PA3EFR/radio_timer_project/ESP32-WeMos-LOLIN32-Lite-pinout-mischianti-low-1024x545.jpg

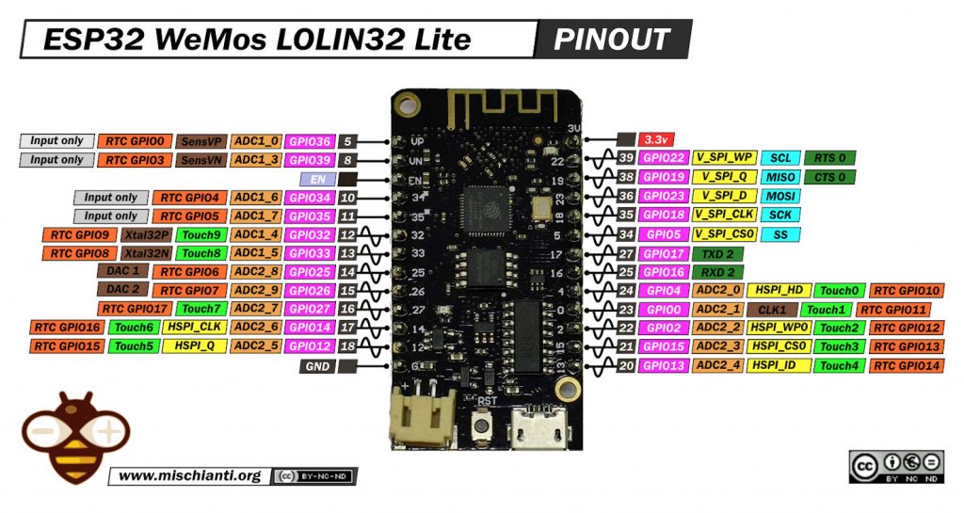
ESP32-WeMos-LOLIN32-Lite-pinout-mischianti-low-1024x545.jpg
