PA3EFR/radio_timer_project/IMG-20251202-WA0028.jpg

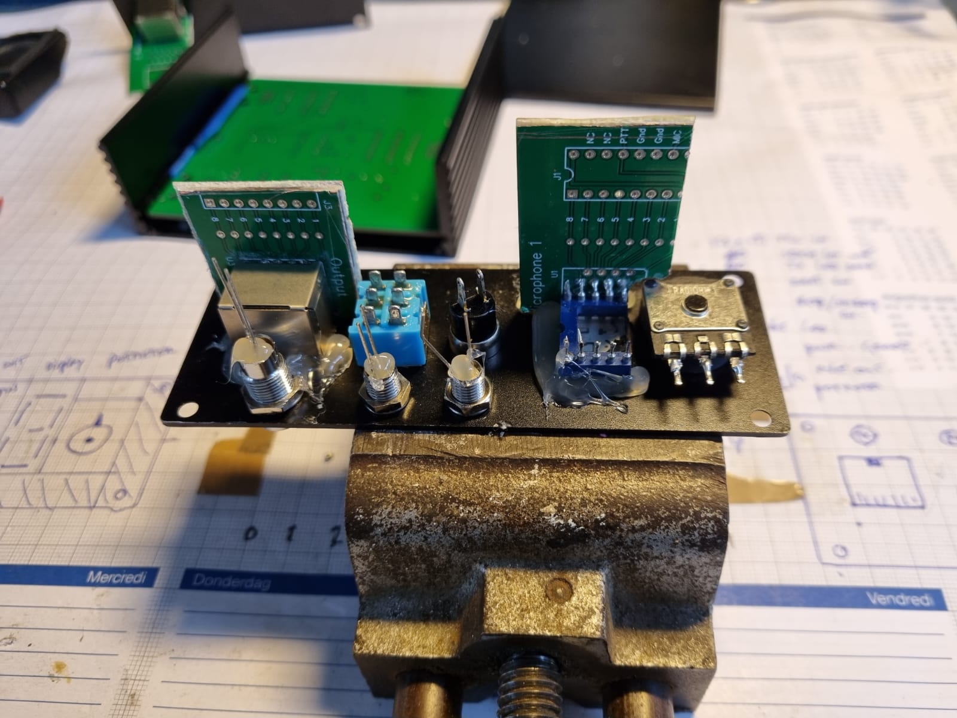
IMG-20251202-WA0028.jpg
