PA3EFR/radio_timer_project/7_Segement_display.jpg

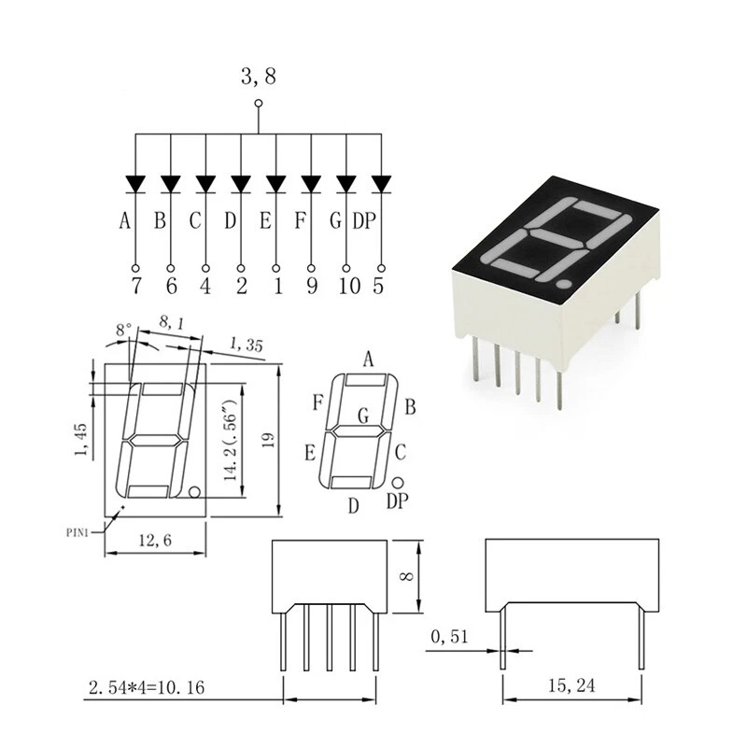
7_Segement_display.jpg
