PA3EFR/radio_timer_project/Mic_layout_GM950.jpg

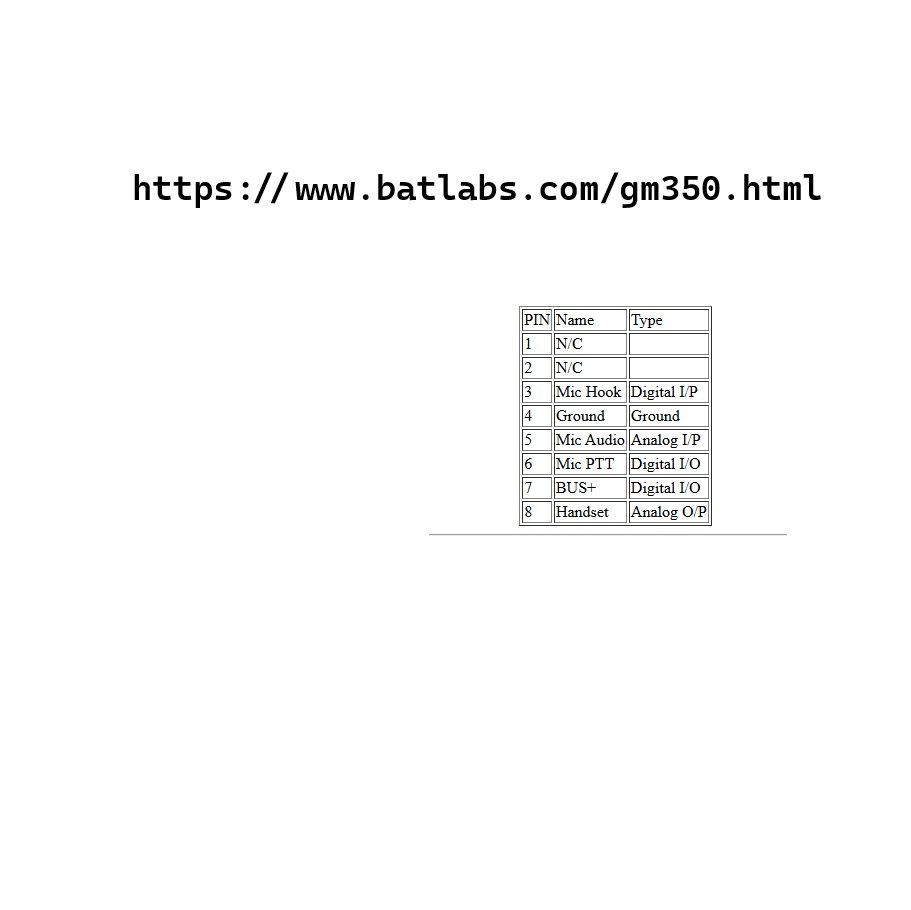
Mic_layout_GM950.jpg
