PA3EFR/radio_timer_project/Lolin32 Lite/Schematic_Audio_timer_Lolin32_2025-12-01.pdf

## ARDUINO LOLIN32 Lite

8

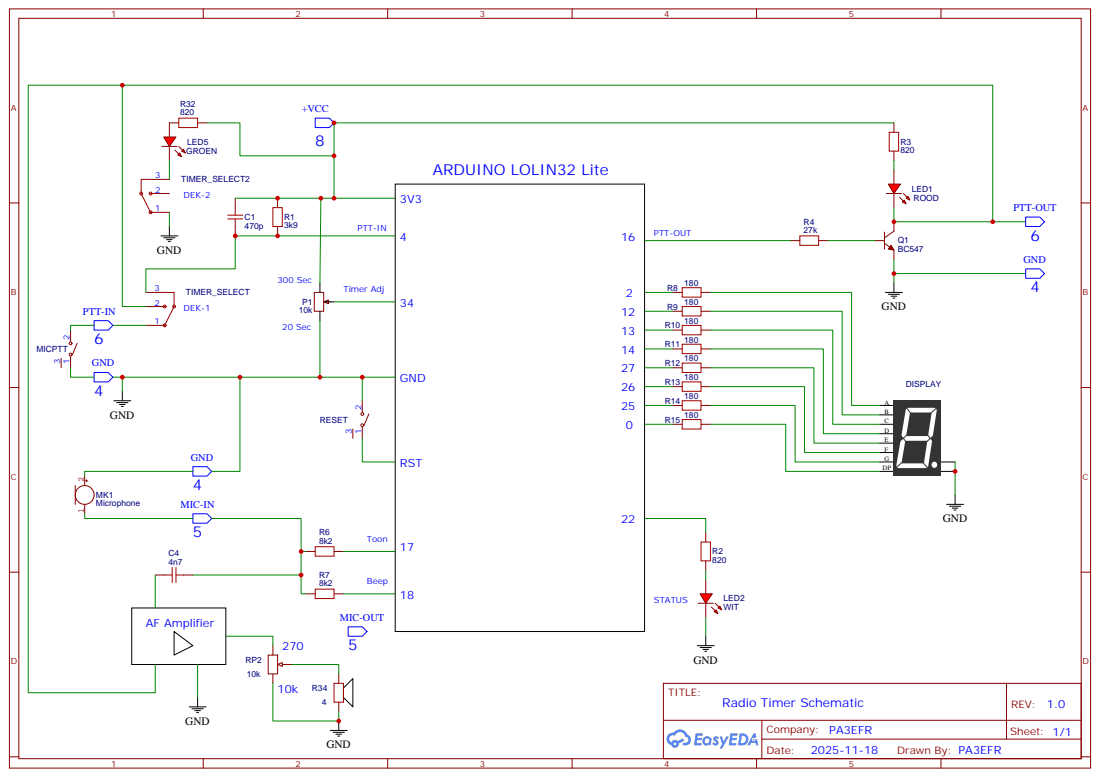
[picture p8: page 1]
