PA3EFR/radio_timer_project/Nano/Schematic_Audio_timer_Nano_2025-12-01.pdf

8

## ARDUINO Nano

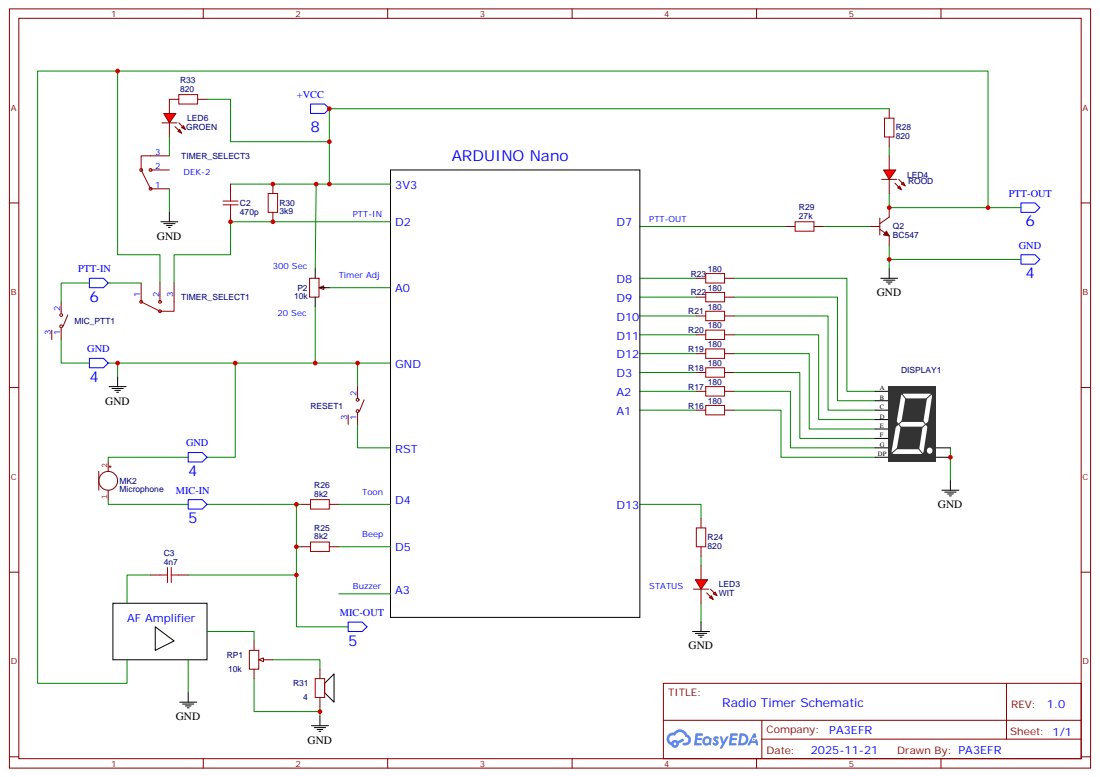
[picture p9: page 1]
