PA3EFR/radio_timer_project/Configuration_electric_Lolin32&Nano.pdf

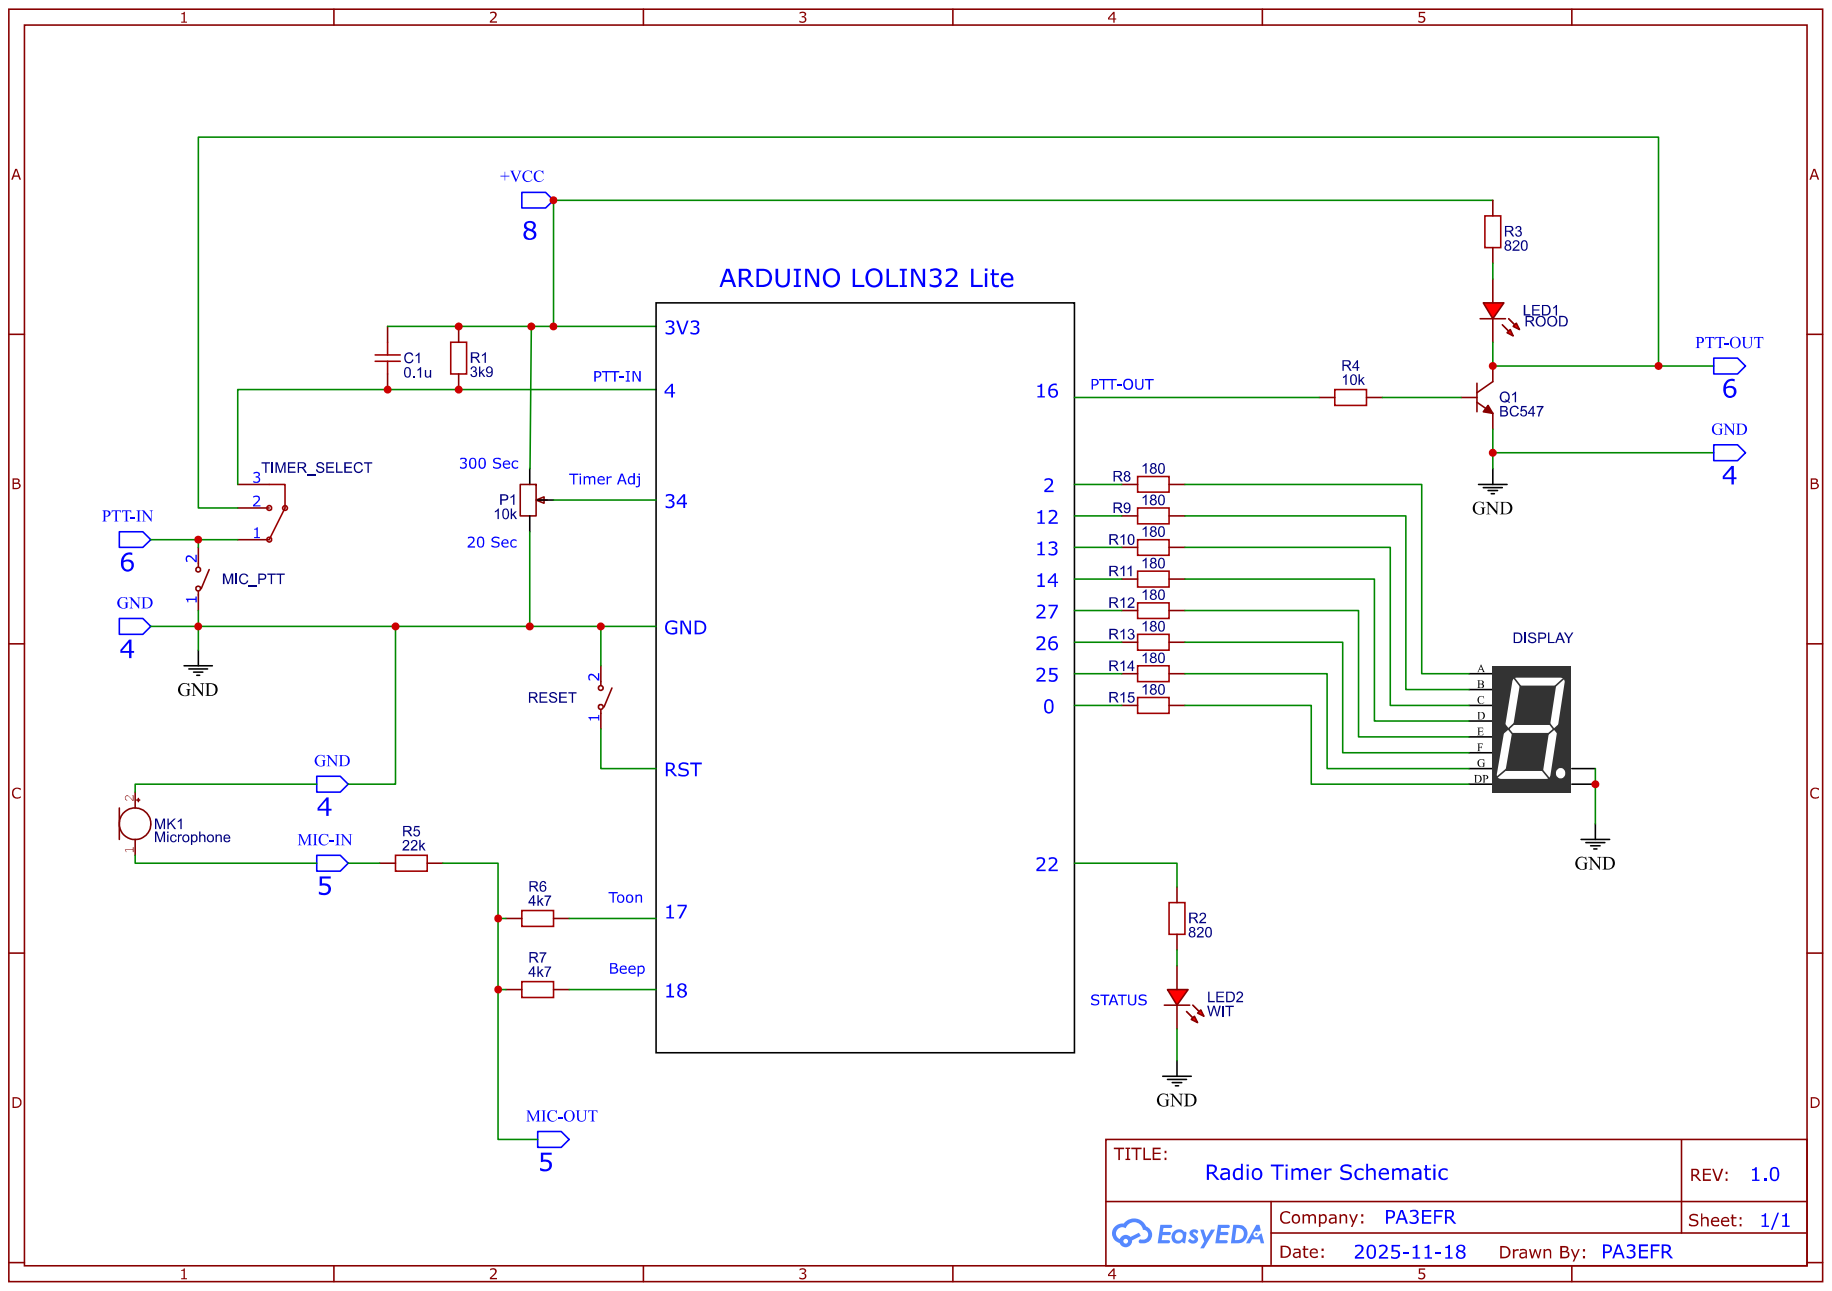
[picture p10: page 1]

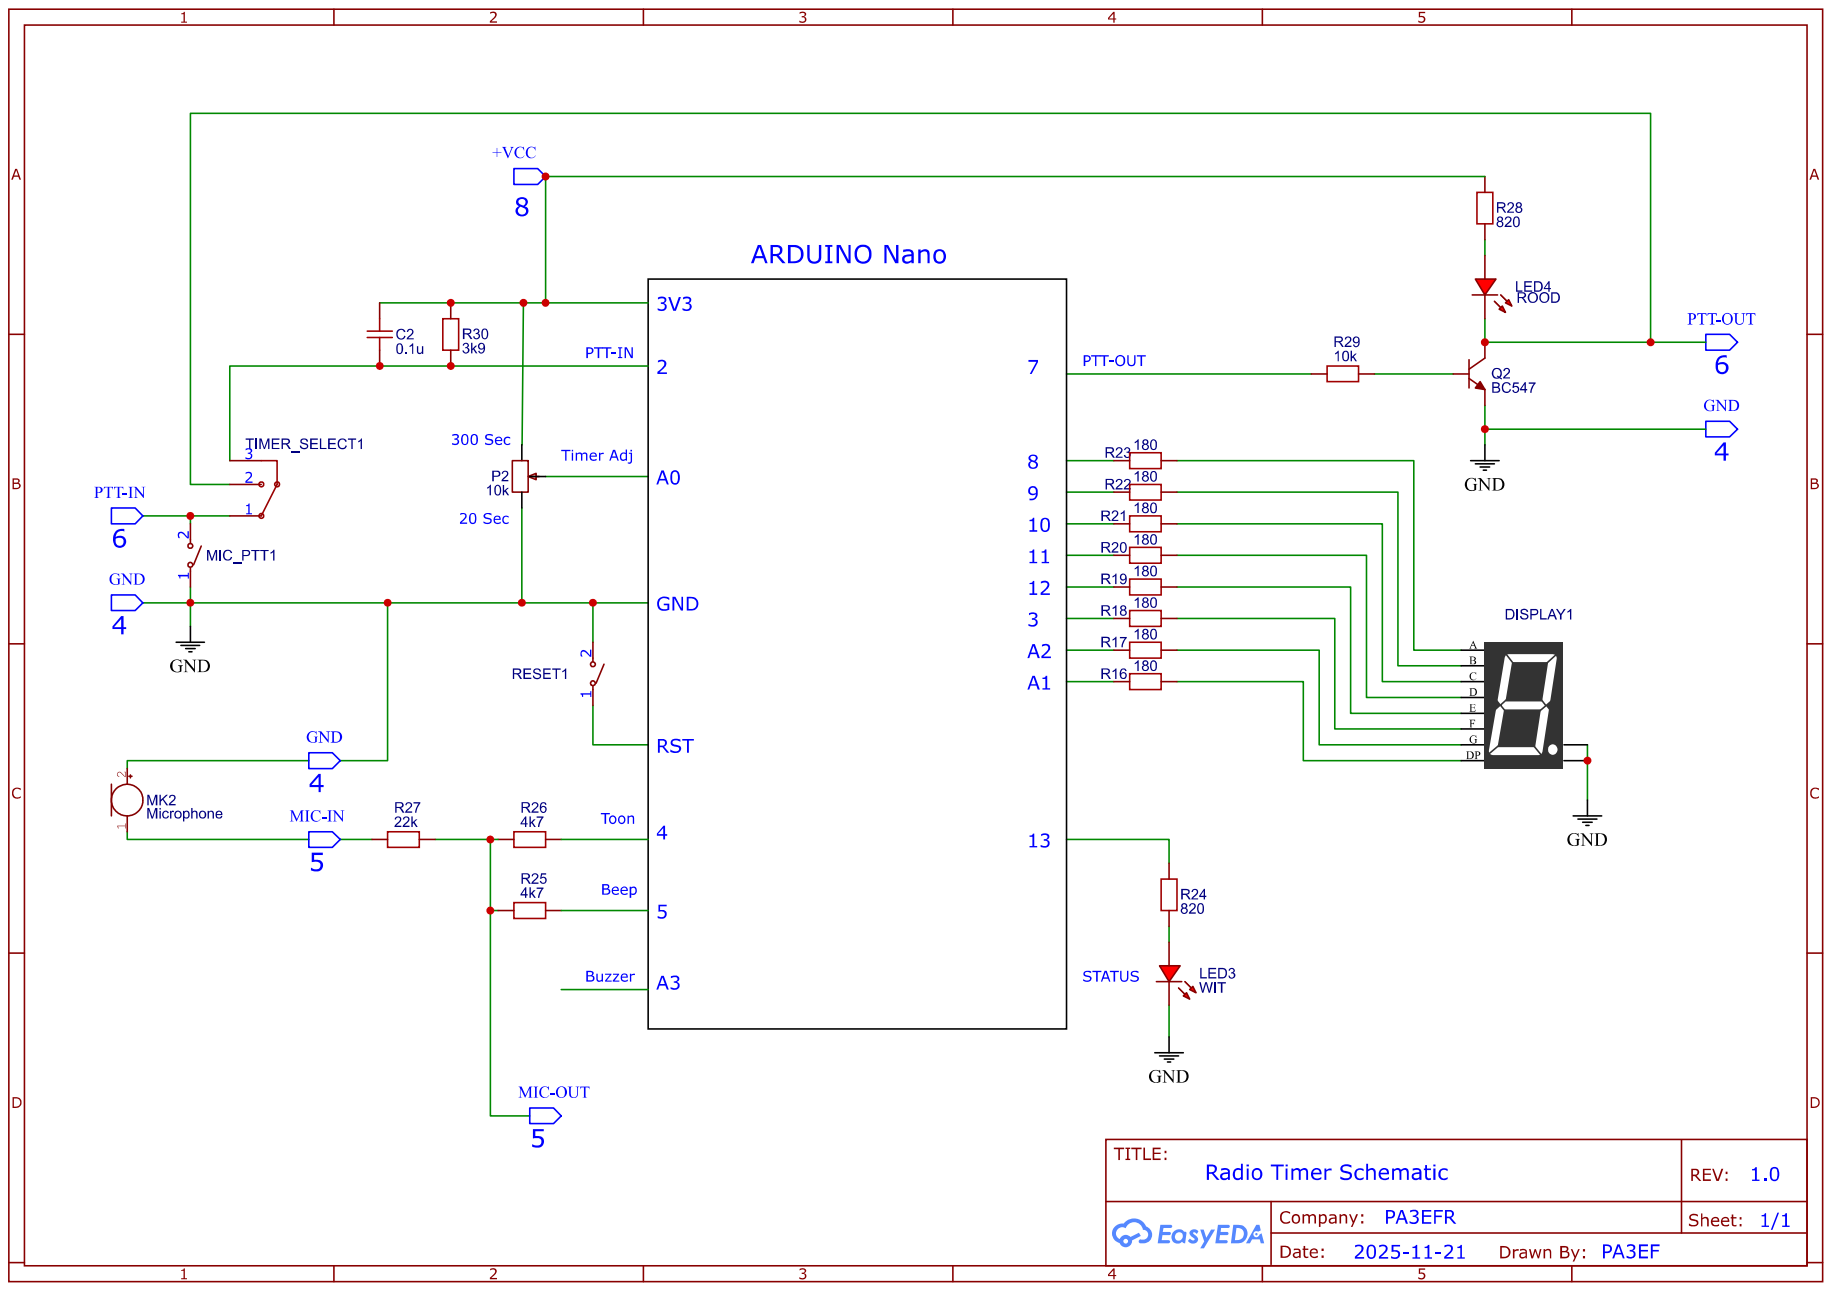
[picture p11: page 2]
